jeanpereirac/Sistema-Fotovoltaico-Automatizado--Rastreador-solar-/TCC/pos-textuais/anexos.tex

% Elemento opcional
%-----------------------------------
%\begin{anexosenv}
%\partanexos

% ANEXO A – Servo Motor
%\includepdf[
%pages=1,
%scale=0.75,
%pagecommand={\chapter{\texorpdfstring{Datasheet do Servo Motor MG996R}{Datasheet do Servo Motor MG996R}}}
%]{pos-textuais/MG996R.PDF}

%\includepdf[
%pages=2,
%scale=0.90,
%pagecommand={}
%]{pos-textuais/MG996R.PDF}

% ANEXO B – RTC DS1307
%\includepdf[
%pages=1,
%scale=0.75,
%pagecommand={\chapter{Datasheet do Módulo RTC DS1307}}
%]{pos-textuais/DS1307.pdf}

%\includepdf[
%pages=2,
%scale=0.90,
%pagecommand={}
%]{pos-textuais/DS1307.pdf}

% ANEXO C – ACS712
%\includepdf[
%pages=1,
%scale=0.75,
%pagecommand={\chapter{Datasheet do Sensor ACS712}}
%]{pos-textuais/acs712.pdf}

%\includepdf[
%pages=2,
%scale=0.80,
%pagecommand={}
%]{pos-textuais/acs712.pdf}

% ANEXO D – Display LCD I2C
%\includepdf[
%pages=1,
%scale=0.65,
%pagecommand={\chapter{Datasheet do Display LCD com Interface I2C}}
%]{pos-textuais/I2C_1602_LCD.pdf}

%\includepdf[
%pages=2,
%scale=0.90,
%pagecommand={}
%]{pos-textuais/I2C_1602_LCD.pdf}

% ANEXO E – Módulo SD
%\includepdf[
%pages=1,
%scale=0.80,
%pagecommand={\chapter{Datasheet do Módulo Leitor de Cartão SD}}
%]{pos-textuais/MicroSD-Module.pdf}

%\includepdf[
%pages=2,
%scale=0.90,
%pagecommand={}
%]{pos-textuais/MicroSD-Module.pdf}

%\end{anexosenv}
