jeanpereirac/Sistema-Fotovoltaico-Automatizado--Rastreador-solar-/TCC/pre-textuais/sigla.tex

%-----------------------------------
% Abbreviations and acronyms
%-----------------------------------

\begin{siglas}
  \item[A] Ampere, unidade de medida da corrente elétrica
\item[ACS712] Sensor de corrente baseado no efeito Hall
\item[BYD] \textit{Build Your Dreams} (Construa Seus Sonhos)
\item[DC] Corrente contínua (\textit{Direct Current})
\item[GND] \textit{Ground} (terra elétrico)
\item[GW] Gigawatt
\item[I2C] \textit{Inter-Integrated Circuit}
\item[IDE] \textit{Integrated Development Environment}
\item[IFNMG] Instituto Federal do Norte de Minas Gerais
\item[LCD] \textit{Liquid Crystal Display}
\item[MATLAB] \textit{MATrix LABoratory}
\item[MPPT] \textit{Maximum Power Point Tracking} (Rastreamento do Ponto de Máxima Potência)
\item[MW] Megawatt
\item[PN] Junção entre semicondutores do tipo P e do tipo N
\item[PoC] \textit{Proof of Concept} (Prova de Conceito)
\item[PWM] \textit{Pulse Width Modulation} (Modulação por Largura de Pulso)
\item[RTC] \textit{Real Time Clock} (Relógio de Tempo Real)
\item[SD] \textit{Secure Digital}
\item[Simulink] Ambiente de simulação do MATLAB
\item[SPI] \textit{Serial Peripheral Interface}
\item[STC] \textit{Standard Test Conditions} (Condições Padrão de Teste)
\item[USB] \textit{Universal Serial Bus}
\item[V] Volt, unidade de medida da tensão elétrica
\item[W] Watt, unidade de medida da potência elétrica

\end{siglas}
