jeanpereirac/Sistema-Fotovoltaico-Automatizado--Rastreador-solar-/TCC/pre-textuais/simbolos.tex

%-----------------------------------
% Symbols
%-----------------------------------

\begin{simbolos}
\item[$G(\%)$] Ganho percentual de geração de energia
\item[$E_r$] Energia total gerada pelo sistema com rastreamento solar
\item[$E_f$] Energia total gerada pelo sistema fixo
\item[$G_{\text{média}}$] Ganho percentual médio
\item[$V$] Tensão elétrica, em volts
\item[$kWh$] Quilowatt-hora
\item[$m^{2}$] Metro quadrado
\item[$kWh/m^{2}/dia$] Irradiação solar diária por unidade de área
\item[$\%$] Porcentagem
\item[$^\circ$] Grau angular
\end{simbolos}
