jeanpereirac/Sistema-Fotovoltaico-Automatizado--Rastreador-solar-/TCC/Figuras/arduino_ide.png

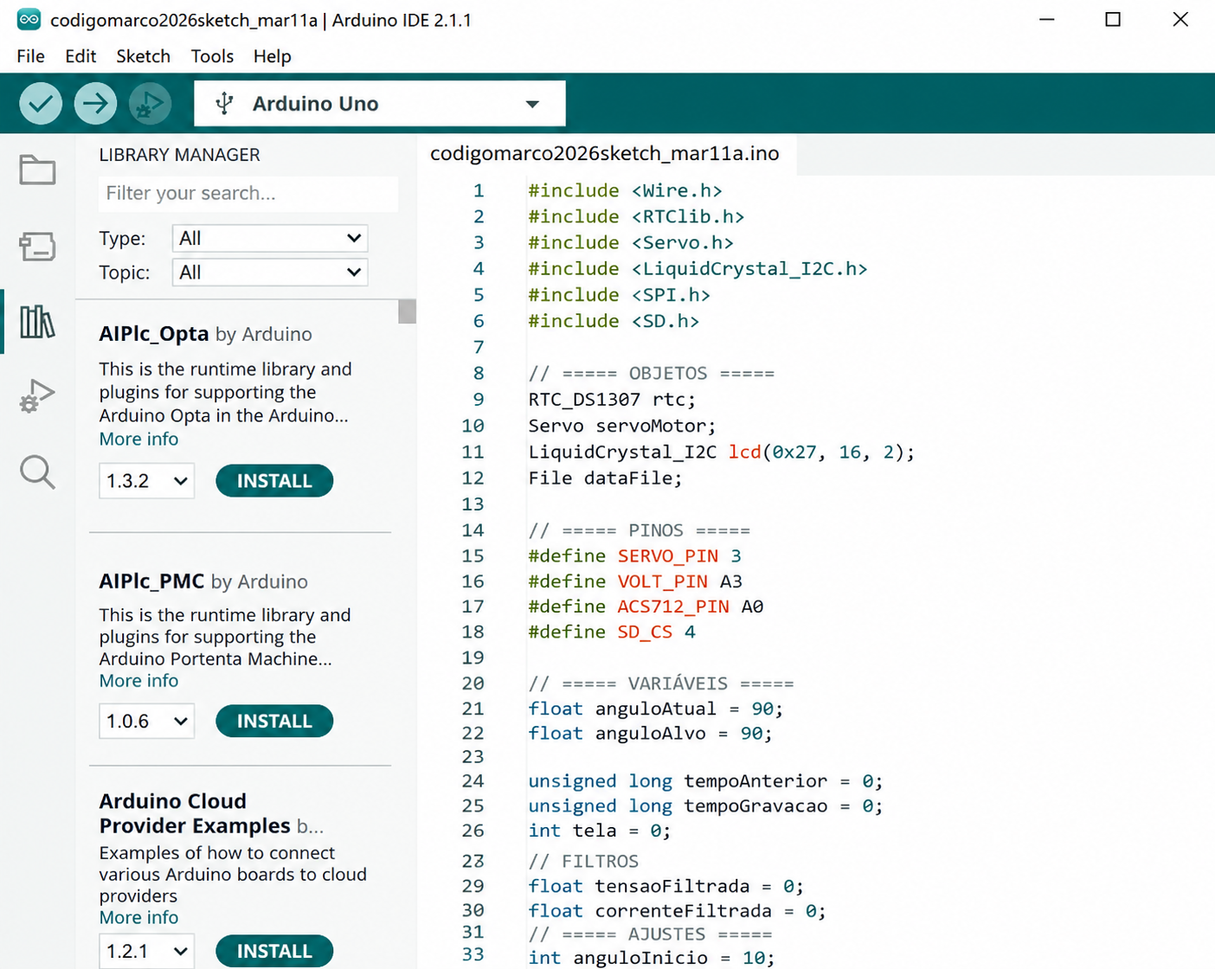
TCC/Figuras/arduino_ide.png
