jeanpereirac/Sistema-Fotovoltaico-Automatizado--Rastreador-solar-/TCC/Figuras/BYD.png

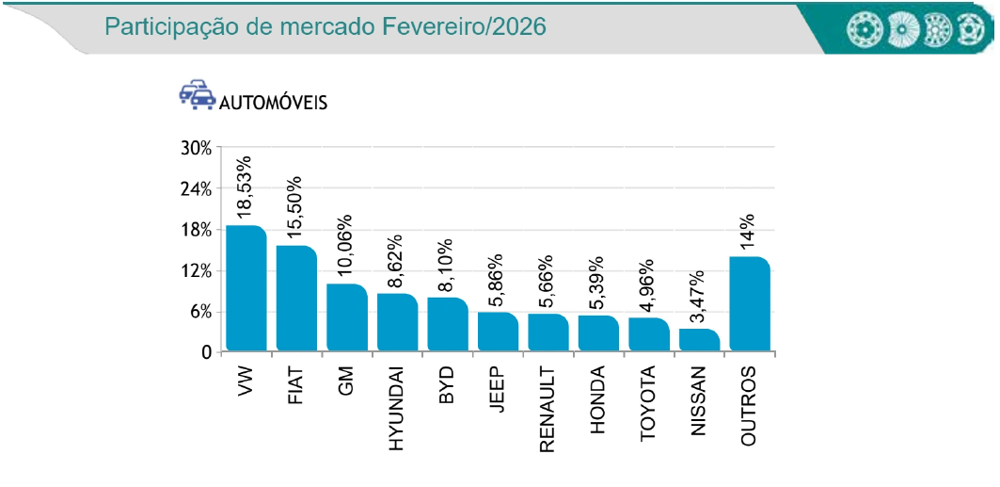
TCC/Figuras/BYD.png
