jeanpereirac/Sistema-Fotovoltaico-Automatizado--Rastreador-solar-/TCC/Figuras/complexo_janauba.png

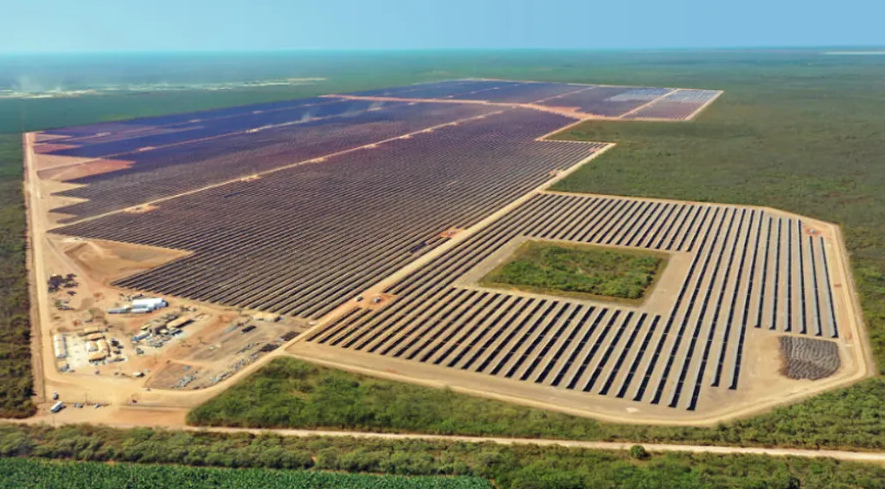
TCC/Figuras/complexo_janauba.png
