jeanpereirac/Sistema-Fotovoltaico-Automatizado--Rastreador-solar-/TCC/Figuras/dia 20.png

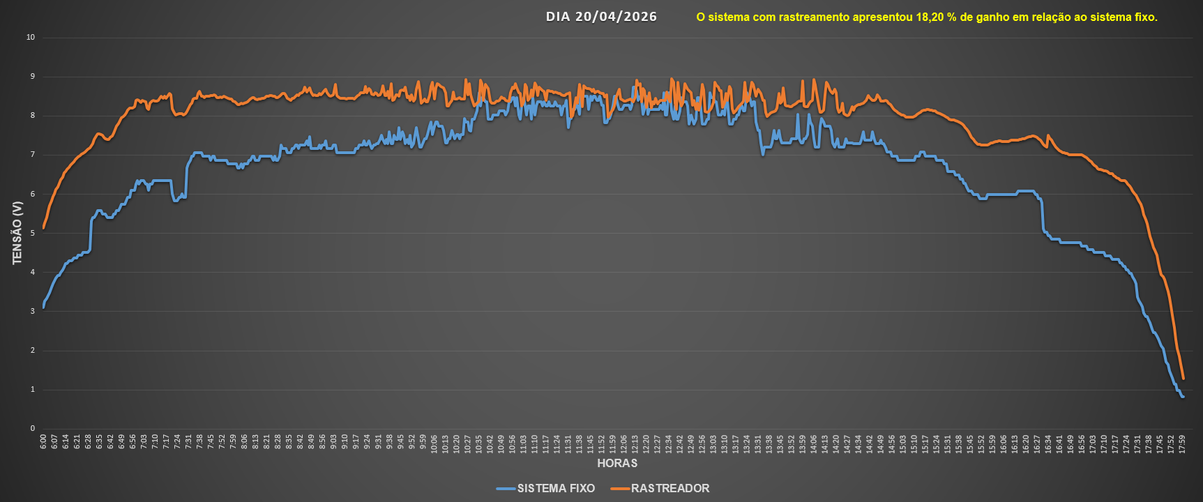
TCC/Figuras/dia 20.png
