jeanpereirac/Sistema-Fotovoltaico-Automatizado--Rastreador-solar-/TCC/Figuras/obliqua.png

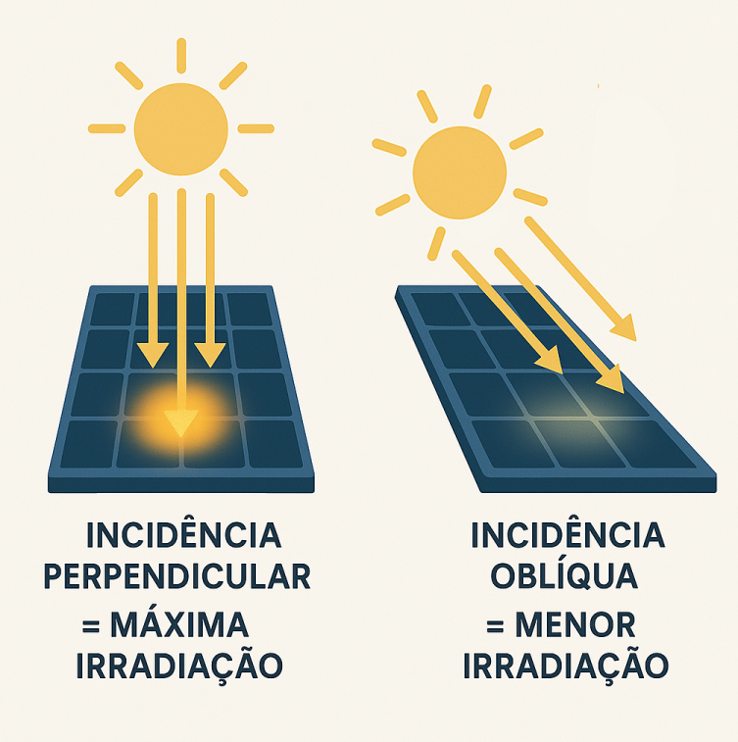
TCC/Figuras/obliqua.png
