jeanpereirac/Sistema-Fotovoltaico-Automatizado--Rastreador-solar-/TCC/Figuras/rastreador-solar-esquema.jpg

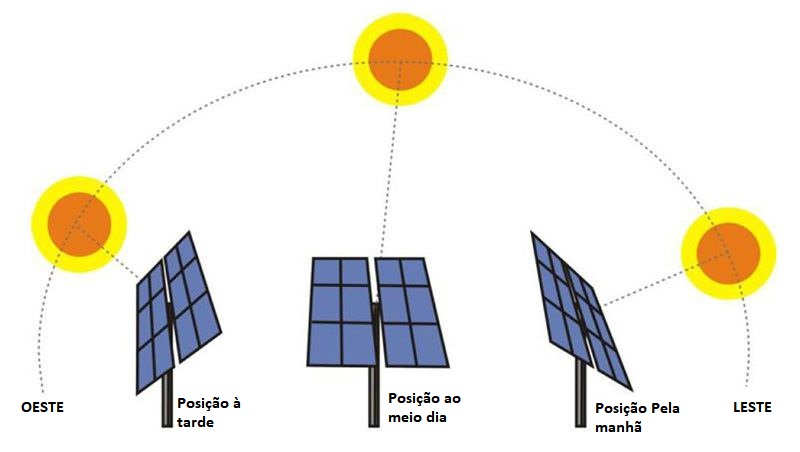
TCC/Figuras/rastreador-solar-esquema.jpg
