jeanpereirac/Sistema-Fotovoltaico-Automatizado--Rastreador-solar-/TCC/Figuras/sistema_embarcado.jpg

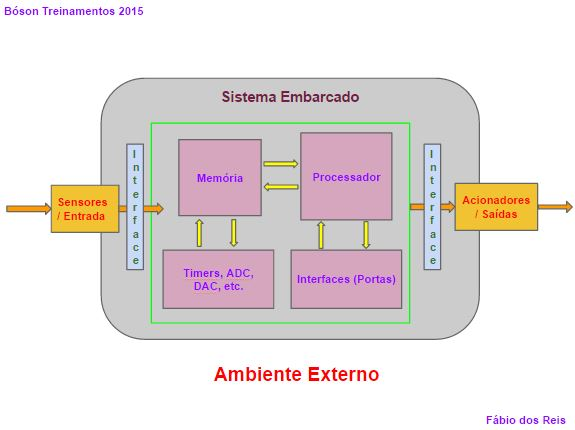
TCC/Figuras/sistema_embarcado.jpg
