jeanpereirac/Sistema-Fotovoltaico-Automatizado--Rastreador-solar-/Dados-Experimentais/dados_experimentais.xlsx

 |  |  |  |  |  |  |  |  |  |  |  |  |  |  |  |  |  |  |  |  |  |  |  |  |  |  |  |  |  |  |  | MEDIAS E GANHOS (%) | DIA 23 | DIA 24 | DIA 25 | DIA 26
DIA 23/05/2026 |  |  |  |  |  |  |  | DIA 24/05/2026 |  |  |  |  |  |  |  | DIA 25/05/2026 |  |  |  |  |  |  |  | DIA 26/05/2026 |  |  |  |  |  |  |  | Média Tensão Fixo | 3.51 | 4.41 | 4.94 | 3.60
SISTEMA FIXO |  |  |  | SISTEMA COM RASTREAMENTO |  |  |  | SISTEMA FIXO |  |  |  | SISTEMA COM RASTREAMENTO |  |  |  | SISTEMA FIXO |  |  |  | SISTEMA COM RASTREAMENTO |  |  |  | SISTEMA FIXO |  |  |  | SISTEMA COM RASTREAMENTO |  |  |  | Média Tensão Rastreador | 4.29 | 5.31 | 6.10 | 4.30
HORAS | TENSAO (V) | CORRENTE (I) | POTENCIA (P=V*I) | ANGULO | TENSAO (V) | CORRENTE (I) | POTENCIA (P=V*I) | HORAS | TENSAO (V) | CORRENTE (I) | POTENCIA (P=V*I) | ANGULO | TENSAO (V) | CORRENTE (I) | POTENCIA (P=V*I) | HORAS | TENSAO (V) | CORRENTE (I) | POTENCIA (P=V*I) | ANGULO | TENSAO (V) | CORRENTE (I) | POTENCIA (P=V*I) | HORAS | TENSAO (V) | CORRENTE (I) | POTENCIA (P=V*I) | ANGULO | TENSAO (V) | CORRENTE (I) | POTENCIA (P=V*I) | Ganho Tensão (%) | 22.32 | 20.40 | 23.33 | 19.54
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
