jeanpereirac/Sistema-Fotovoltaico-Automatizado--Rastreador-solar-/(commit log)

2026-08-11 Organiza estrutura do projeto e adiciona arquivos do sistema
    [dados_experimentais.xlsx]
2026-08-11 Remove capítulo de desenvolvimento do sistema
